AFMD/b40/images/b40.png

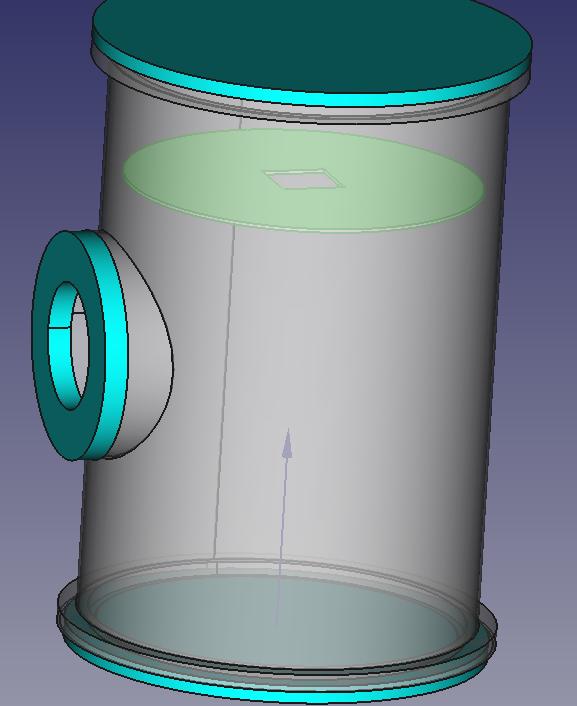
images/b40.png
