AFMD/b40/sample_and_mask_wheels/images/cFive.png

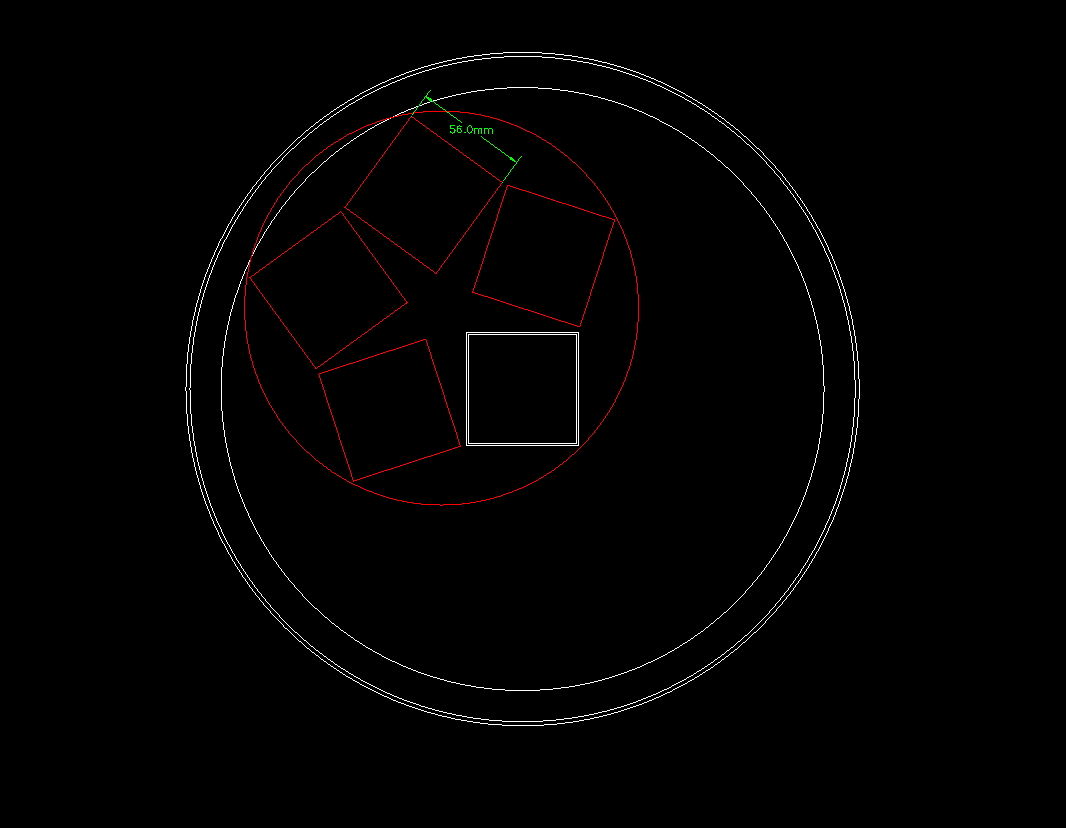
sample_and_mask_wheels/images/cFive.png
