AFMD/b40/sample_and_mask_wheels/images/cFour.png

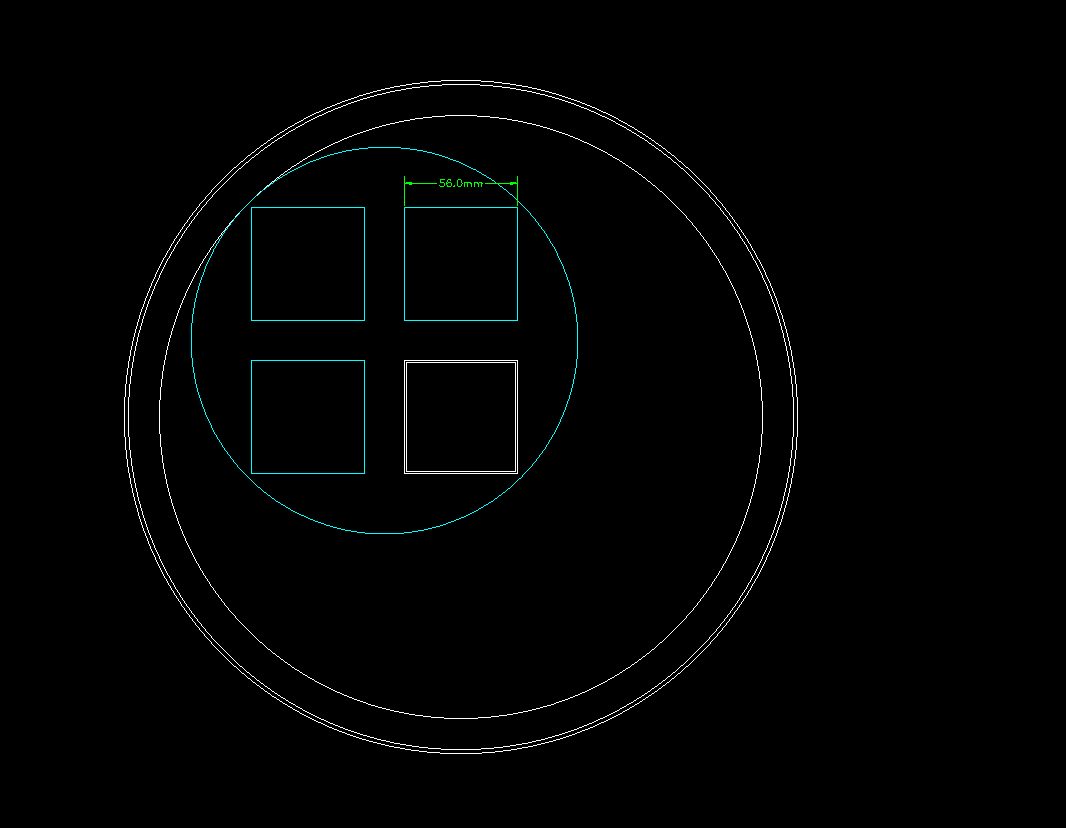
sample_and_mask_wheels/images/cFour.png
