AFMD/b40/sample_and_mask_wheels/engineeringDrawings/sampleBlock.fcstd

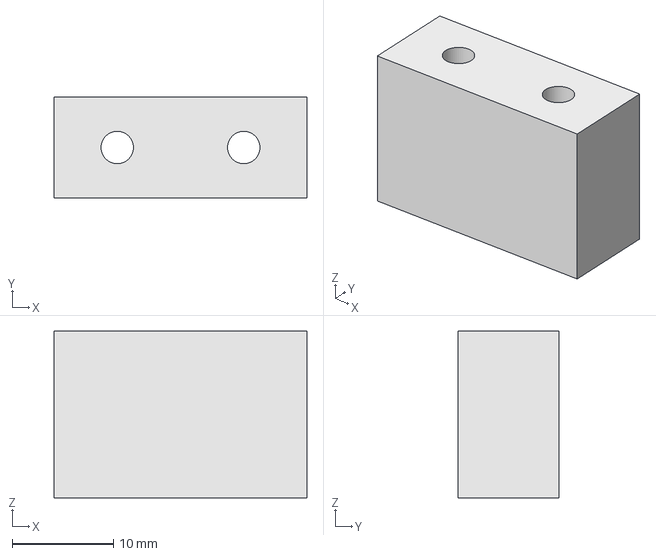
[picture p7: CAD file, 2016-03-01]
sample_and_mask_wheels/engineeringDrawings/sampleBlock.fcstd
25.0 x 10.0 x 16.5 mm
