AFMD/b40/sample_and_mask_wheels/output/parts_to_make/sampleTrayD.step

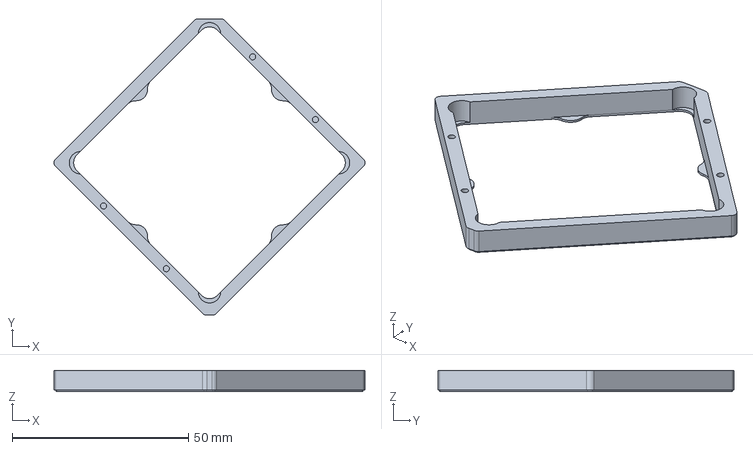
[picture p8: CAD file, 2018-11-02]
sample_and_mask_wheels/output/parts_to_make/sampleTrayD.step
88.3 x 84.2 x 6.00 mm
