AFMD/b40/sample_and_mask_wheels/engineeringDrawings/motorBar.fcstd

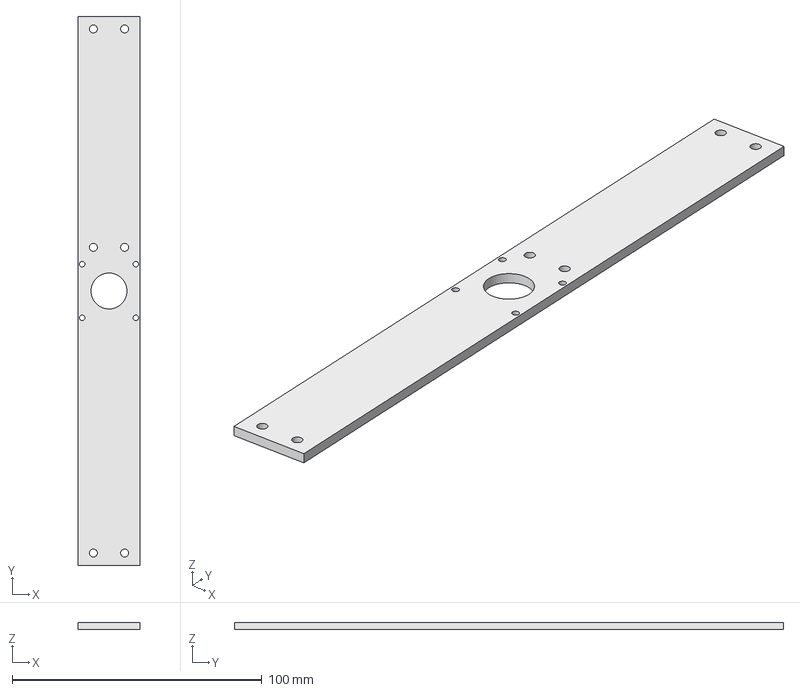
[picture p9: CAD file, 2016-03-01]
sample_and_mask_wheels/engineeringDrawings/motorBar.fcstd
25.0 x 220.0 x 3.00 mm
