AFMD/b40/sample_and_mask_wheels/input/zss_25_axial.step

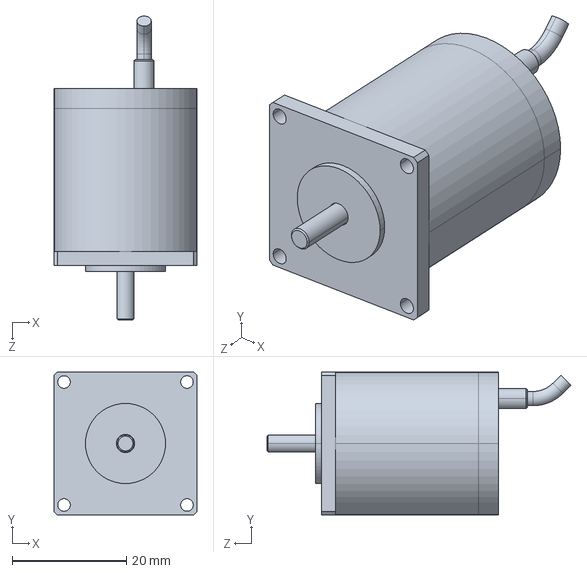
[picture p10: CAD file, 2016-02-29]
sample_and_mask_wheels/input/zss_25_axial.step
25.0 x 25.0 x 53.1 mm
