AFMD/b40/sample_and_mask_wheels/engineeringDrawings/maskBlock.fcstd

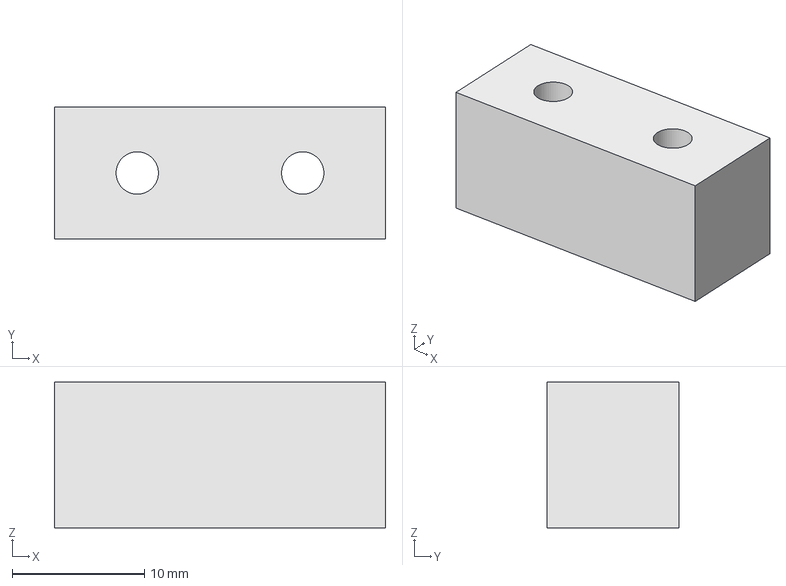
[picture p11: CAD file, 2016-03-01]
sample_and_mask_wheels/engineeringDrawings/maskBlock.fcstd
25.0 x 10.0 x 11.0 mm
