AFMD/b40/sample_and_mask_wheels/output/b40_chamber.step

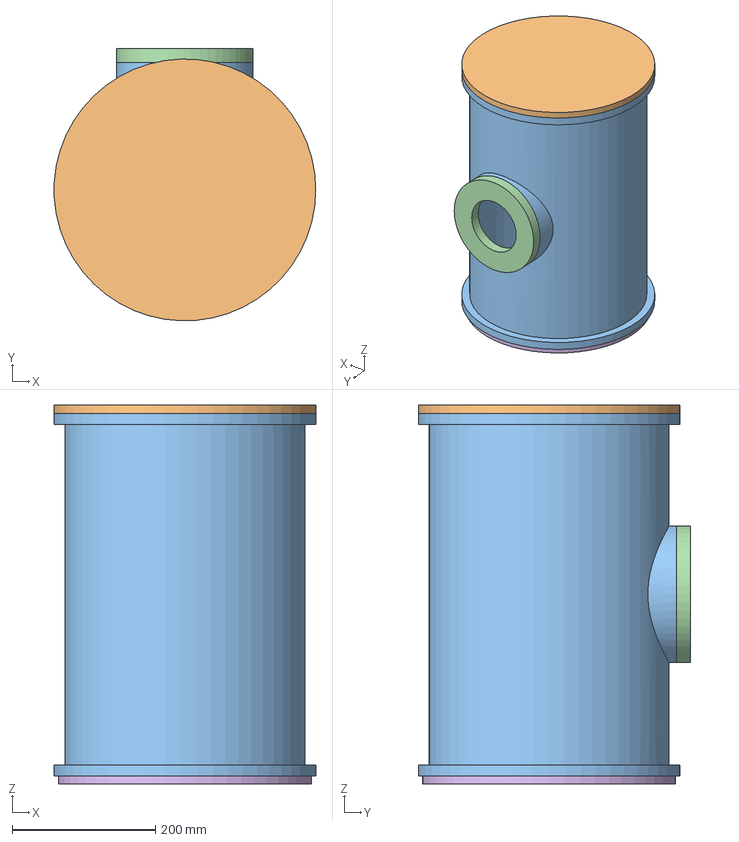
[picture p12: CAD file, 2018-11-02]
sample_and_mask_wheels/output/b40_chamber.step
364.7 x 379.9 x 528.4 mm
