AFMD/b40/sample_and_mask_wheels/output/everything.step

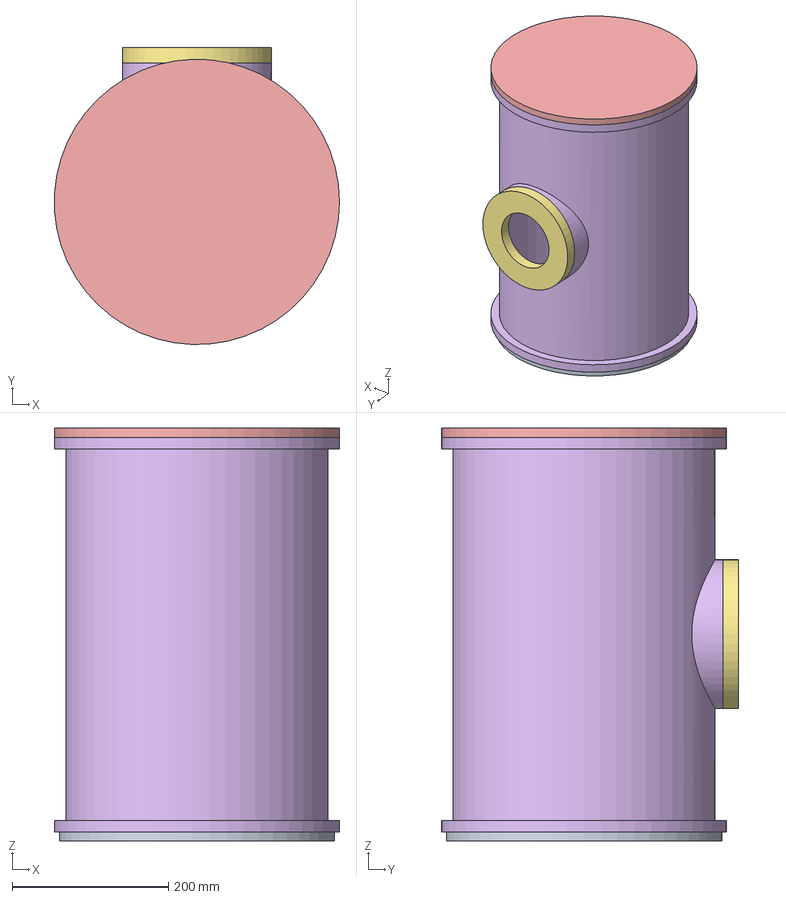
[picture p13: CAD file, 2017-05-02]
sample_and_mask_wheels/output/everything.step
364.7 x 379.9 x 528.4 mm
