AFMD/b40/sample_and_mask_wheels/output/parts_to_make/sampleWheel.step

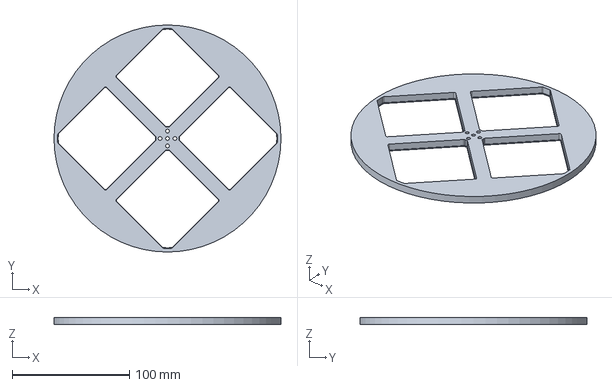
[picture p14: CAD file, 2018-11-02]
sample_and_mask_wheels/output/parts_to_make/sampleWheel.step
194.0 x 194.0 x 6.00 mm
