AFMD/b40/sample_and_mask_wheels/output/parts_to_make/maskWheel.step

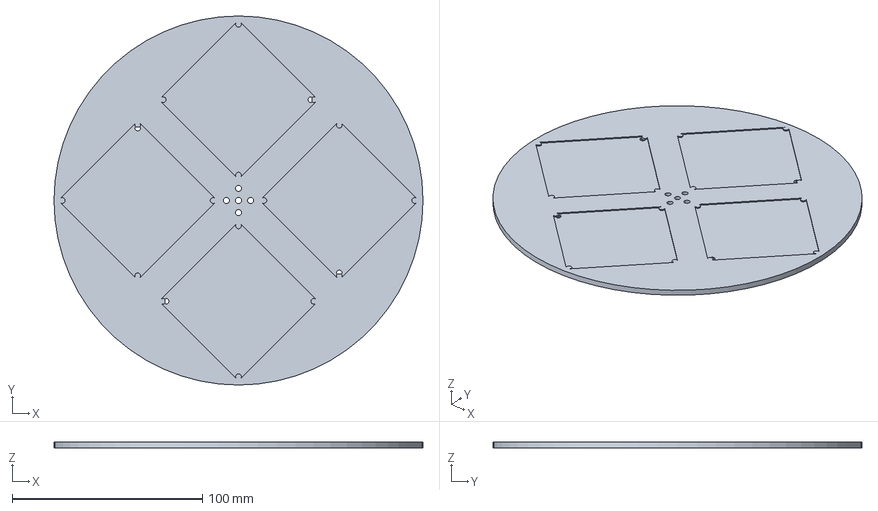
[picture p15: CAD file, 2018-11-02]
sample_and_mask_wheels/output/parts_to_make/maskWheel.step
194.0 x 194.0 x 3.00 mm
