AFMD/b40/(list of files, cad)

Other CAD files:
sample_and_mask_wheels/output/parts_to_make/sampleTrayC.step
sample_and_mask_wheels/output/parts_to_make/sampleBlockB.step
sample_and_mask_wheels/output/sampleTray.stl
sample_and_mask_wheels/input/midSection_markedUp.dwg
sample_and_mask_wheels/output/parts_to_make/sampleBlockA.step
sample_and_mask_wheels/output/parts_to_make/sampleMotorBar.step
sample_and_mask_wheels/output/parts_to_make/maskBlockB.step
sample_and_mask_wheels/output/parts_to_make/sampleTrayA.step
sample_and_mask_wheels/output/parts_to_make/maskBlockA.step
sample_and_mask_wheels/output/parts_to_make/sampleTrayB.step
sample_and_mask_wheels/output/parts_to_make/maskMotorBar.step
sample_and_mask_wheels/input/30mmM3setScrew.STEP
sample_and_mask_wheels/input/665921.STP
