AFMD/b40/sample_and_mask_wheels/kicad/wheel_driver/wheel_driver.pdf

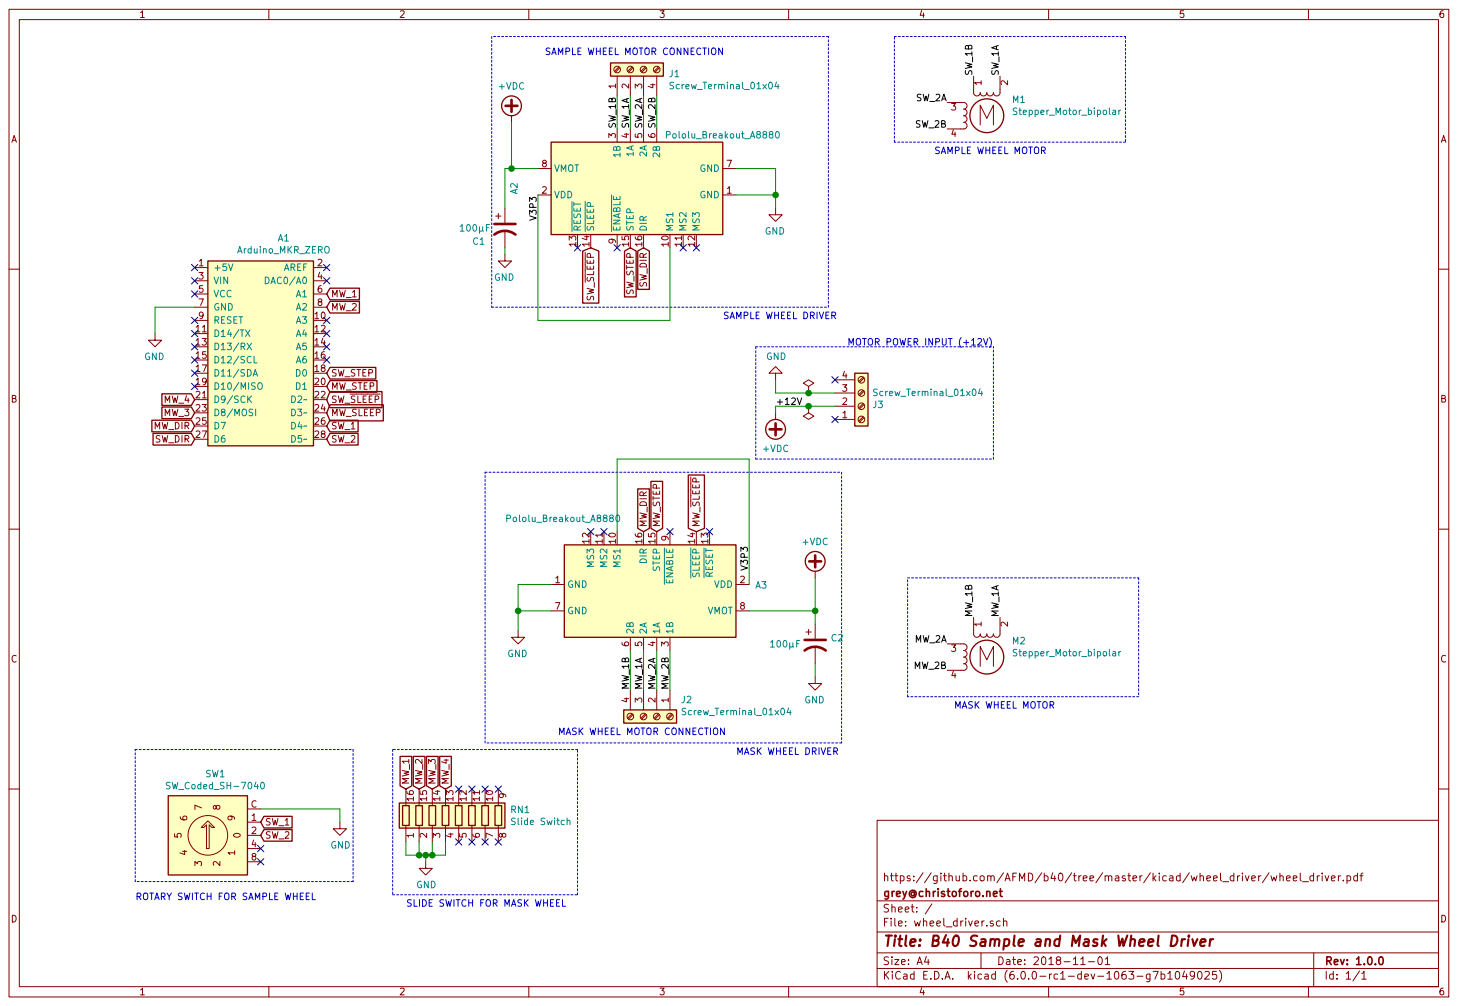
[picture p16: page 1]

SAMPLE WHEEL MOTOR CONNECTION MASK WHEEL MOTOR CONNECTION
J1Screw_Terminal_01x04 MASK WHEEL DRIVER

J3Screw_Terminal_01x04 MOTOR POWER INPUT (+12V) GND

https://github.com/AFMD/b40/tree/master/kicad/wheel_driver/wheel_driver.pdf
File: wheel_driver.sch Sheet: / grey@christoforo.net

Id: 1/1 Title: B40 Sample and Mask Wheel Driver
