AFMD/b40/sample_and_mask_wheels/kicad/wheel_driver/wheel_driver.kicad_pcb

## KiCad design RecieverAndController/roller_blade.kicad_pcb

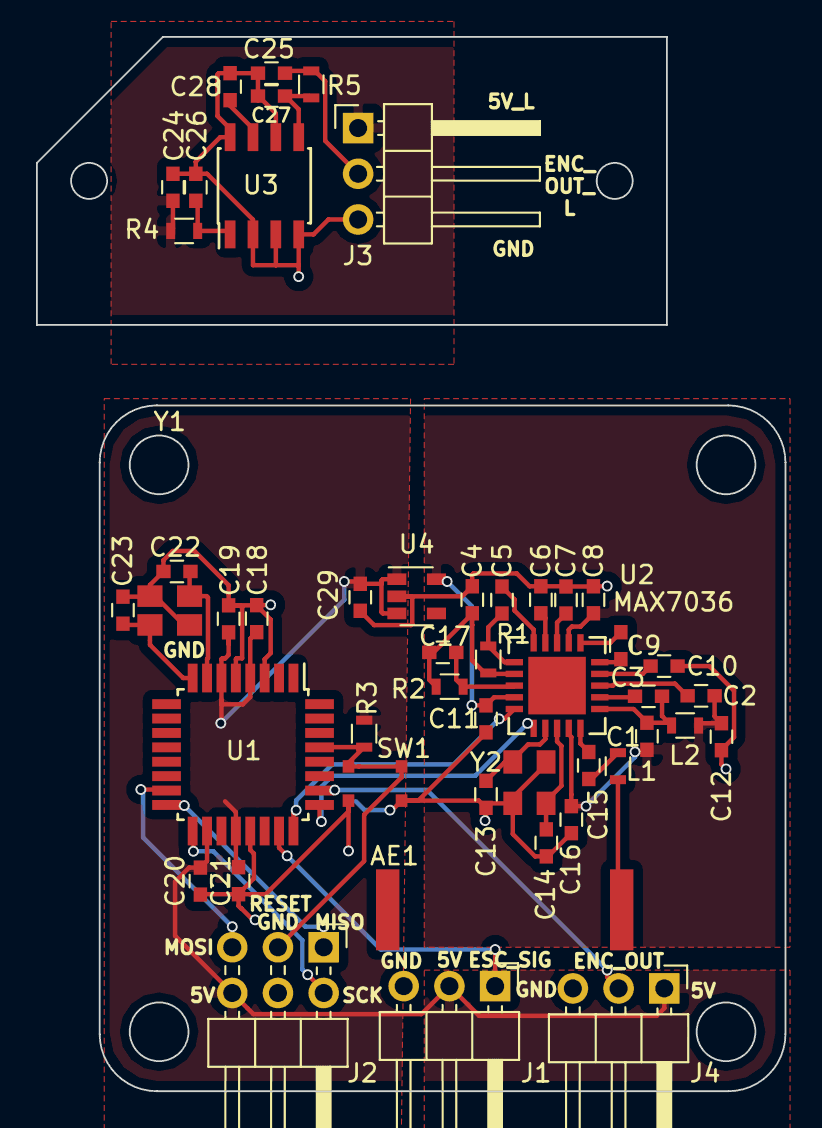
[picture p17: board roller_blade.kicad_pcb from above]

Board: 2 copper layers, 38.1 x 38.1 mm, 48 parts (0 on the bottom side), 36 nets.

Parts:
AE1: Antenna; 311-1570-1-ND
C1: 2.7pF; C_0603
C2, C3, C15: 100pF; C_0603
C4, C11, C16, C17: .1uF; C_0603
C5: 390pF; C_0603
C6: 180pF; C_0603
C7, C29: 1uF; C_0603
C8: .01uF; C_0603
C9: 22pF; C_0603
C10, C13, C14: 10pF; C_0603
C12: 220pF; C_0603
C18, C19, C20, C21, C26, C27, C28: 100nF; C_0603
C22, C23: 18pF; C_0603
C24, C25: 1nF; C_0603
J1, J3, J4: Conn_01x03; Pin_Header_Angled_1x03_Pitch2.54mm
J2: Conn_02x03_Counter_Clockwise; Pin_Header_Angled_2x03_Pitch2.54mm
L1: 47nH; L_0603
L2: 15nH; L_0603
R1: 22kOHM; R_0603
R2: 220kOhm; R_0603
R3: 10k; R_0603
R4: 10; R_0603
R5: 50; R_0603
SW1: SW_DIP_x01; CKN10291CT-ND
U1: ATMEGA328-AU; TQFP-32_7x7mm_Pitch0.8mm
U2: MAX7036; MAX7036GTP
U3: MLX90365; SOIC-8_3.9x4.9mm_Pitch1.27mm
U4: AP2204_3V3; SOT-23-5
Y1: 16MHz; SER3686DKR-ND
Y2: 13.56MHz; 1253-1737-1-ND

Connections:
+3V3: C1.2, C2.2, C8.2, C11.1, C12.1, C16.1, L2.1, U2.4, U2.12, U2.19, U4.5
+5V: C18.1, C19.1, C20.1, C21.1, C29.1, J1.2, J2.6, J4.1, R3.1, U1.4, U1.6, U1.18, U1.20, U4.1, U4.3
/ENC_OUT: J4.2, U1.26
/ESC_SIG: J1.1, U1.23
/MCU/MISO: J2.1, U1.16
/MCU/MOSI: J2.5, U1.15
/MCU/RESET: J2.3, R3.2, SW1.1, U1.29
/MCU/SCK: J2.2, U1.17
/REC_EN: U1.25, U2.1
/REC_OUT: U1.24, U2.20
/encoder/5V_L: C24.1, J3.1, R4.2
/encoder/ENC_OUT_L: C25.2, J3.2, R5.2
/encoder/GND_L: C24.2, C25.1, C26.2, C27.1, C28.2, J3.3, U3.2, U3.3, U3.4, U3.6, U3.8
GND: C4.2, C6.2, C7.2, C8.1, C10.2, C11.2, C12.2, C13.2, C14.2, C16.2, C18.2, C19.2, C20.2, C21.2, C22.1, C23.1, C29.2, J1.3, J2.4, J4.3, SW1.2, U1.3, U1.5, U1.21, U4.2, Y1.2, Y1.4, Y2.2, Y2.4
unnamed: AE1.1, L1.1
unnamed: C1.1, C3.2, L2.2, U2.6
unnamed: C2.1, U2.8
unnamed: C3.1, U2.7
unnamed: C5.1, U2.15
unnamed: C5.2, R1.2, U2.16
unnamed: C6.1, U2.14
unnamed: C7.1, U2.13
unnamed: C9.1, U2.10
unnamed: C9.2, U2.11
unnamed: C10.1, U2.9
unnamed: C13.1, U2.2, Y2.1
unnamed: C14.1, U2.3, Y2.3
unnamed: C15.1, U2.5
unnamed: C15.2, L1.2
unnamed: C4.1, C17.1, R1.1, R2.1, U2.17
unnamed: C17.2, R2.2, U2.18
unnamed: C22.2, U1.7, Y1.1
unnamed: C23.2, U1.8, Y1.3
unnamed: C26.1, R4.1, U3.1
unnamed: C27.2, R5.1, U3.5
unnamed: C28.1, U3.7
