AFMD/b40/(commit log)

2016-02-29 rename b40 folder
    [30mmM3setScrew.STEP, 665921.STP, entireChamber.step, finalAssembly.fcstd, midSection_markedUp.dwg, output.stl, sampleWheel2D.dxf, zss_25_axial.step]
2016-02-29 add 4x M1.6 close fit diameter grabber holes to the sameple tray and clean up file structure
    [30mmM3setScrew.STEP, 665921.STP, entireChamber.step, midSection_markedUp.dwg, output.stl, sampleWheel2D.dxf, zss_25_axial.step]
2016-02-29 cleaned up some directory stuff
    [entireChamber.step, finalAssembly.fcstd, sampleWheel2D.dxf]
2016-02-29 couldn't get this to import if it isn't in top level
    [sampleWheel2D.dxf]
2016-03-01 made some engineering drawings for the easy parts
    [maskBlock.fcstd, motorBar.fcstd, sampleBlock.fcstd]
2016-03-01 ezfreecad is now a git module and is properly imported
    [everything.step]
2016-03-01 don't track .pyc
2016-03-01 add parts_to_make folder
    [everything.step]
2016-03-01 update the everything.step
    [everything.step]
2016-05-22 make one step file for everything
    [everything.step]
2016-05-22 bring this up to date with the latest ezFreeCAD
    [everything.step]
2016-05-22 manage ezFreeCAD with a link
    [everything.step]
2017-04-23 small radius cutting tool gone
    [everything.step, sampleWheel2D.dxf]
2017-04-23 add heeks folder
    [everything.step]
2017-04-23 toolpath generated for sampleTray
    [everything.step, sampleWheel2D.dxf]
2017-04-23 nc file done
    [everything.step]
2017-05-01 fix path to freecad include
    [everything.step]
2017-05-02 add pocket operation around part
    [everything.step]
2017-05-02 try not to mill the whole middle
2018-01-25 add baseplate drawing
    [basePlate2D.dxf]
2018-11-01 add wheel driver kicad project and firmware
    [wheel_driver.kicad_pcb, wheel_driver.sch]
2018-11-01 remove top level output folder
    [everything.step]
2018-11-01 add board connection picture
2018-11-01 add svg version of schematic
2018-11-01 add motor connections to schematifc
    [wheel_driver.sch]
2018-11-01 fix cap value in schemtaic
    [wheel_driver.sch]
2018-11-01 change schematic link to pdf download
2018-11-02 add output files
    [b40_chamber.step, everything.step, maskBlockA.step, maskBlockB.step, maskMotorBar.step, maskWheel.step, sampleBlockA.step, sampleBlockB.step]
2018-11-05 update board labels
2018-11-15 change scematic to +12v input
    [wheel_driver.sch]
2018-11-15 44V becomes 12V
2018-11-15 keep amber LED on during wheels movement
2018-11-15 add power down and up instructions
